usmanmehmood55/FYP-PCB/BOM FYP_PCB.xlsx

Item | Qty | Reference(s) | Value | LCSC Ref | Footprint | LibPart
1 | 1 | BT1 | 14.8V | C395852 | TerminalBlock:TerminalBlock_bornier-2_P5.08mm | Device:Battery
2 | 1 | BT2 | 11.1V | C395852 | TerminalBlock:TerminalBlock_bornier-2_P5.08mm | Device:Battery
3 | 2 | C1, C39 | 1uF | C77080 | Capacitor_SMD:C_0805_2012Metric | Device:C_Small
4 | 6 | C2, C3, C5, C6, C7, C8 | 0.1uF | C136621 | Capacitor_SMD:C_0805_2012Metric | Device:C_Small
5 | 8 | C4, C9, C11, C13, C19, C25, C31, C43 | 100nF | C136621 | Capacitor_SMD:C_0805_2012Metric | Device:C_Small
6 | 2 | C10, C12 | 100uF | C371251 | Capacitor_SMD:CP_Elec_8x10 | Device:CP_Small
7 | 9 | C14, C17, C20, C23, C26, C29, C32, C35, C42 | 4.7uF | C7188 | Capacitor_Tantalum_SMD:CP_EIA-3528-15_AVX-H | Device:CP_Small
8 | 8 | C15, C18, C21, C24, C27, C30, C33, C36 | 220nF | C11364 | Capacitor_Tantalum_SMD:CP_EIA-3216-18_Kemet-A | Device:CP_Small
9 | 4 | C16, C22, C28, C34 | 330uF | C110162 | Capacitor_SMD:CP_Elec_8x10 | Device:CP_Small
10 | 2 | C37, C38 | 4.7uF | C7188 | Capacitor_Tantalum_SMD:CP_EIA-3528-15_AVX-H | Device:C_Small
11 | 2 | C40, C44 | 10nF | C472835 | Capacitor_SMD:C_0805_2012Metric | Device:C_Small
12 | 1 | C41 | 2.2nF | C28260 | Capacitor_SMD:C_0805_2012Metric | Device:C_Small
13 | 2 | C45, C46 | 22pF | C129647 | Capacitor_SMD:C_0805_2012Metric | Device:C_Small
14 | 3 | D1, D2, D3 | LED | C192671 | LED_SMD:LED_0805_2012Metric_Pad1.15x1.40mm_HandSolder | Device:LED
15 | 5 | D4, D5, D6, D7, D8 | 5A | C24138 | Diode_SMD:D_SMC | Device:D_Schottky
16 | 4 | H1, H2, H3, H4 | MH | ~~~~~~~ | MountingHole:MountingHole_3.2mm_M3_Pad_Via | Mechanical:MountingHole
17 | 1 | J1 | UART | C160259 | Connector_JST:JST_EH_B3B-EH-A_1x03_P2.50mm_Vertical | Connector_Generic:Conn_01x03
18 | 1 | J2 | i2c_jetson | C160259 | Connector_JST:JST_EH_B3B-EH-A_1x03_P2.50mm_Vertical | Connector_Generic:Conn_01x03
19 | 1 | J3 | T-Block | C395852 | TerminalBlock:TerminalBlock_bornier-2_P5.08mm | Connector:Screw_Terminal_01x02
20 | 1 | J4 | USB_B_Mini | C105424 | Connector_USB:USB_Mini-B_Lumberg_2486_01_Horizontal | Connector:USB_B_Mini
21 | 2 | JP1, JP2 | SolderJumper_2_Bridged | ~~~~~~~ | Jumper:SolderJumper-2_P1.3mm_Bridged2Bar_RoundedPad1.0x1.5mm | Jumper:SolderJumper_2_Bridged
22 | 4 | L1, L2, L3, L4 | 15uH | C364084 | Inductor_SMD:L_Pulse_PA4320 | Device:L_Small
23 | 1 | L5 | 2.4uH | C325963 | Inductor_SMD:L_Pulse_PA4320 | Device:L_Small
24 | 2 | M1, M2 | PL37D | C265407 | Connector_JST:JST_EH_S6B-EH_1x06_P2.50mm_Horizontal | PL37D:PL37D
25 | 2 | M3, M4 | Servo | C160259 | Connector_JST:JST_EH_B3B-EH-A_1x03_P2.50mm_Vertical | Motor:Motor_Servo
26 | 2 | Q1, Q2 | BSS138 | C427380 | Package_TO_SOT_SMD:SOT-23 | Transistor_FET:BSS138
27 | 8 | R1, R4, R5, R6, R24, R26, R28, R30 | 10K | C237755 | Resistor_SMD:R_0805_2012Metric | Device:R_Small_US
28 | 2 | R2, R3 | 1M | C228604 | Resistor_SMD:R_0805_2012Metric | Device:R_Small_US
29 | 2 | R7, R9 | 0.1R | C149858 | Resistor_SMD:R_2512_6332Metric | Device:R_Small_US
30 | 2 | R8, R10 | 31K | C327034 | Resistor_SMD:R_0805_2012Metric | Device:R_Small_US
31 | 4 | R11, R12, R13, R14 | 1K | C269744 | Resistor_SMD:R_0805_2012Metric | Device:R_Small_US
32 | 4 | R15, R16, R17, R18 | 2K | C95700 | Resistor_SMD:R_0805_2012Metric | Device:R_Small_US
33 | 2 | R19, R20 | 10K | C237755 | Resistor_SMD:R_1206_3216Metric | Device:R_Small_US
34 | 3 | R21, R22, R23 | 83R | C229019 | Resistor_SMD:R_0805_2012Metric | Device:R_Small_US
35 | 2 | R25, R27 | 1.1K | C325794 | Resistor_SMD:R_0805_2012Metric | Device:R_Small_US
36 | 1 | R29 | 5.8k | C204215 | Resistor_SMD:R_0805_2012Metric | Device:R_Small_US
37 | 1 | R31 | 3.2k | C17609 | Resistor_SMD:R_0805_2012Metric | Device:R_Small_US
38 | 1 | R32 | 10k | C237755 | Resistor_SMD:R_0805_2012Metric | Device:R_Small_US
39 | 1 | R33 | 102k | C204145 | Resistor_SMD:R_0805_2012Metric | Device:R_Small_US
40 | 1 | R34 | 36.5k | C204450 | Resistor_SMD:R_0805_2012Metric | Device:R_Small_US
41 | 1 | R35 | 20k | C465476 | Resistor_SMD:R_0805_2012Metric | Device:R_Small_US
42 | 1 | R36 | 4.7K | C60816 | Resistor_SMD:R_0805_2012Metric | Device:R_Small_US
43 | 1 | SW1 | BOOT/FLASH | C319371 | Button_Switch_SMD:SW_SPST_CK_RS282G05A3 | Switch:SW_Push
44 | 1 | SW2 | RESET | C319371 | Button_Switch_SMD:SW_SPST_CK_RS282G05A3 | Switch:SW_Push
45 | 2 | SW3, SW4 | iChop | C4673 | Button_Switch_SMD:SW_DIP_SPSTx05_Slide_6.7x14.26mm_W8.61mm_P2.54mm_LowProfile | Switch:SW_DIP_x05
46 | 2 | U1, U2 | DRV8840 | C95203 | Package_SO:HTSSOP-28-1EP_4.4x9.7mm_P0.65mm_EP3.4x9.5mm_Mask2.4x6.17mm_ThermalVias | Driver_Motor:DRV8840
47 | 1 | U3 | ESP32-WROOM-32D | C473012 | RF_Module:ESP32-WROOM-32 | RF_Module:ESP32-WROOM-32D
48 | 1 | U4 | LSF0204 | C202288 | Package_SO:TSSOP-14-1EP_4.4x5mm_P0.65mm | LSF0204:LSF0204
49 | 4 | U5, U6, U7, U8 | TPS5450 | C114425 | Package_SO:HSOP-8-1EP_3.9x4.9mm_P1.27mm_EP2.41x3.1mm_ThermalVias | TPS5450:TPS5450
50 | 1 | U9 | LT8364 | ~~~~~~~ | Package_SO:MSOP-12-16-1EP_3x4mm_P0.5mm_EP1.65x2.85mm_ThermalVias | LT8364:LT8364
51 | 1 | U10 | CH340G | C14267 | Package_SO:SOIC-16_3.9x9.9mm_P1.27mm | Interface_USB:CH340G
52 | 1 | U11 | ESDA6V8AV5 | C268741 | Package_TO_SOT_SMD:SOT-553 | ESDA6V8AV5:ESDA6V8AV5
53 | 1 | Y1 | 12MHz | C387348 | Crystal:Crystal_SMD_3225-4Pin_3.2x2.5mm | Device:Crystal_GND24
