usmanmehmood55/FYP-PCB/FYP PCB.kicad_pcb

## KiCad design FYP PCB.kicad_pcb (2020-02-18)

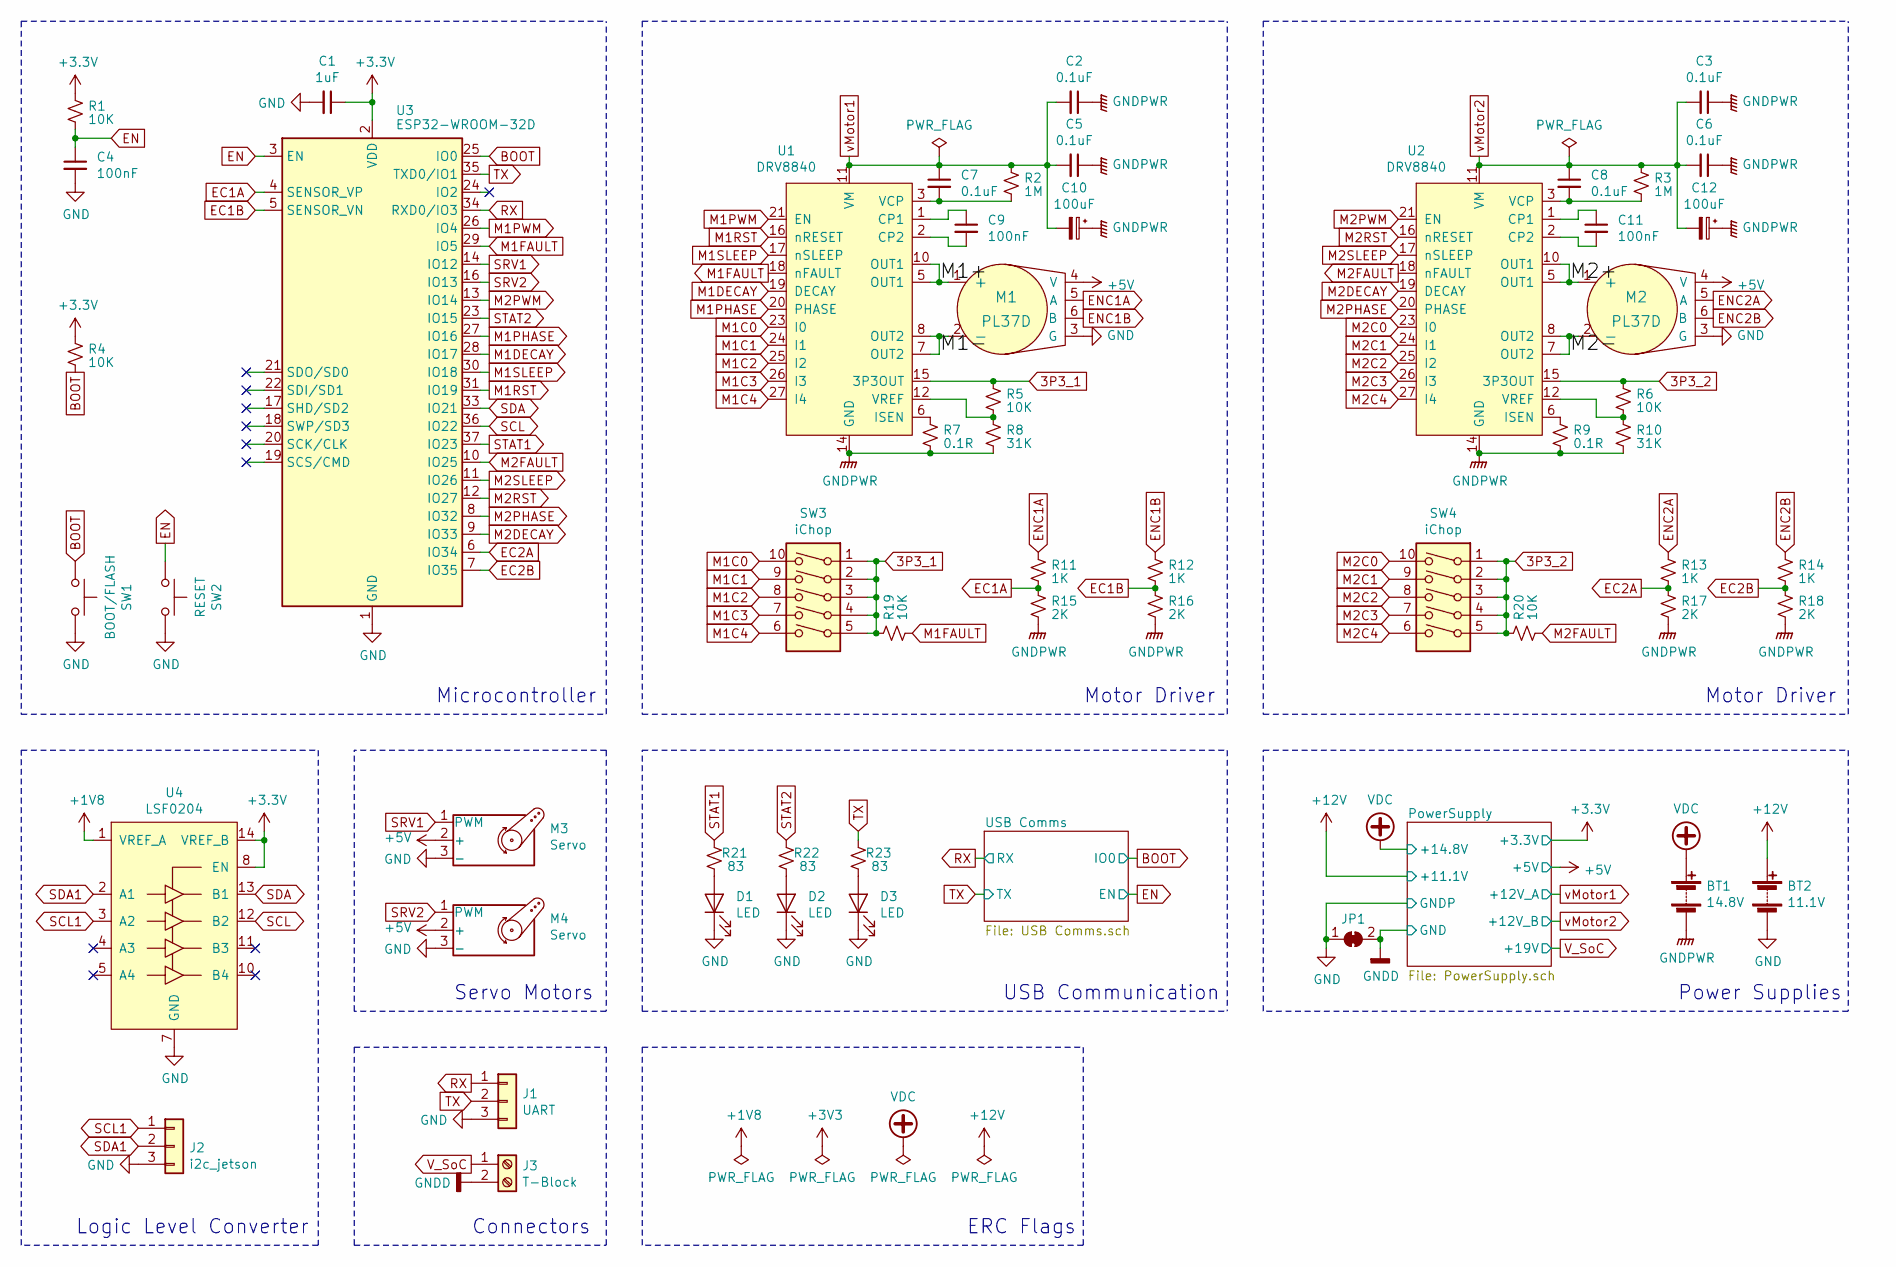
[picture p1: schematic FYP PCB.sch, Motor Driver and Power Delivery]

Parts:
BT1: 14.8V; TerminalBlock_bornier-2_P5.08mm
BT2: 11.1V; TerminalBlock_bornier-2_P5.08mm
C1: 1uF; C_0805_2012Metric
C2, C3, C5, C6, C7, C8: 0.1uF; C_0805_2012Metric
C4, C9, C11: 100nF; C_0805_2012Metric
C10, C12: 100uF; CP_Elec_8x10
D1, D2, D3: LED; LED_0805_2012Metric_Pad1.15x1.40mm_HandSolder
J1: UART; JST_EH_B3B-EH-A_1x03_P2.50mm_Vertical
J2: i2c_jetson; JST_EH_B3B-EH-A_1x03_P2.50mm_Vertical
J3: T-Block; TerminalBlock_bornier-2_P5.08mm
JP1: SolderJumper_2_Bridged; SolderJumper-2_P1.3mm_Bridged2Bar_RoundedPad1.0x1.5mm
M1, M2: PL37D; JST_EH_S6B-EH_1x06_P2.50mm_Horizontal
M3, M4: Servo; JST_EH_B3B-EH-A_1x03_P2.50mm_Vertical
R1, R4, R5, R6: 10K; R_0805_2012Metric
R2, R3: 1M; R_0805_2012Metric
R7, R9: 0.1R; R_2512_6332Metric
R8, R10: 31K; R_0805_2012Metric
R11, R12, R13, R14: 1K; R_0805_2012Metric
R15, R16, R17, R18: 2K; R_0805_2012Metric
R19, R20: 10K; R_1206_3216Metric
R21, R22, R23: 83; R_0805_2012Metric
SW1: BOOT/FLASH; SW_SPST_CK_RS282G05A3
SW2: RESET; SW_SPST_CK_RS282G05A3
SW3, SW4: iChop; SW_DIP_SPSTx05_Slide_6.7x14.26mm_W8.61mm_P2.54mm_LowProfile
U1, U2: DRV8840; HTSSOP-28-1EP_4.4x9.7mm_P0.65mm_EP3.4x9.5mm_Mask2.4x6.17mm_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
U3: ESP32-WROOM-32D; ESP32-WROOM-32
U4: LSF0204; TSSOP-14-1EP_4.4x5mm_P0.65mm

Connections:
3P3_1: R5.1, R19.1, SW3.1, SW3.2, SW3.3, SW3.4, SW3.5, U1.15 (3P3OUT)
3P3_2: R6.1, R20.1, SW4.1, SW4.2, SW4.3, SW4.4, SW4.5, U2.15 (3P3OUT)
+3V3: C1.1, R1.1, R4.1, U3.2 (VDD), U4.8 (EN), U4.14 (VREF_B); also elsewhere on the board
+5V: M1.4 (V), M2.4 (V), M3.2 (+), M4.2 (+); also elsewhere on the board
+12V: BT2.1 (+); also elsewhere on the board
/M1+: M1.1 (+), U1.5 (OUT1), U1.10 (OUT1)
/M1-: M1.2 (-), U1.7 (OUT2), U1.8 (OUT2)
/M2+: M2.1 (+), U2.5 (OUT1), U2.10 (OUT1)
/M2-: M2.2 (-), U2.7 (OUT2), U2.8 (OUT2)
BOOT: R4.2, SW1.1, U3.25 (IO0); also elsewhere on the board
EC1A: R11.2, R15.1, U3.4 (SENSOR_VP)
EC1B: R12.2, R16.1, U3.5 (SENSOR_VN)
EC2A: R13.2, R17.1, U3.6 (IO34)
EC2B: R14.2, R18.1, U3.7 (IO35)
EN: C4.1, R1.2, SW2.1, U3.3 (EN); also elsewhere on the board
ENC1A: M1.5 (A), R11.1
ENC1B: M1.6 (B), R12.1
ENC2A: M2.5 (A), R13.1
ENC2B: M2.6 (B), R14.1
GNDD: J3.2, JP1.2 (B); also elsewhere on the board
M1C0: SW3.10, U1.23 (I0)
M1C1: SW3.9, U1.24 (I1)
M1C2: SW3.8, U1.25 (I2)
M1C3: SW3.7, U1.26 (I3)
M1C4: SW3.6, U1.27 (I4)
M1DECAY: U1.19 (DECAY), U3.28 (IO17)
M1FAULT: R19.2, U1.18 (nFAULT), U3.29 (IO5)
M1PHASE: U1.20 (PHASE), U3.27 (IO16)
M1PWM: U1.21 (EN), U3.26 (IO4)
M1RST: U1.16 (nRESET), U3.31 (IO19)
M1SLEEP: U1.17 (nSLEEP), U3.30 (IO18)
M2C0: SW4.10, U2.23 (I0)
M2C1: SW4.9, U2.24 (I1)
M2C2: SW4.8, U2.25 (I2)
M2C3: SW4.7, U2.26 (I3)
M2C4: SW4.6, U2.27 (I4)
M2DECAY: U2.19 (DECAY), U3.9 (IO33)
M2FAULT: R20.2, U2.18 (nFAULT), U3.10 (IO25)
M2PHASE: U2.20 (PHASE), U3.8 (IO32)
M2PWM: U2.21 (EN), U3.13 (IO14)
M2RST: U2.16 (nRESET), U3.12 (IO27)
M2SLEEP: U2.17 (nSLEEP), U3.11 (IO26)
unnamed: C7.2, R2.2, U1.3 (VCP)
unnamed: C8.2, R3.2, U2.3 (VCP)
unnamed: C9.1, U1.1 (CP1)
unnamed: C9.2, U1.2 (CP2)
unnamed: C11.1, U2.1 (CP1)
unnamed: C11.2, U2.2 (CP2)
unnamed: D1.2 (A), R21.2
unnamed: D2.2 (A), R22.2
unnamed: D3.2 (A), R23.2
unnamed: R5.2, R8.1, U1.12 (VREF), U1.13 (VREF)
unnamed: R7.1, U1.6 (ISEN), U1.9 (ISEN)
unnamed: R9.1, U2.6 (ISEN), U2.9 (ISEN)
unnamed: R6.2, R10.1, U2.12 (VREF), U2.13 (VREF)
RX: J1.1, U3.34 (RXD0/IO3); also elsewhere on the board
SCL: U3.36 (IO22), U4.12 (B2)
SCL1: J2.1, U4.3 (A2)
SDA: U3.33 (IO21), U4.13 (B1)
SDA1: J2.2, U4.2 (A1)
SRV1: M3.1 (PWM), U3.14 (IO12)
SRV2: M4.1 (PWM), U3.16 (IO13)
STAT1: R21.1, U3.37 (IO23)
STAT2: R22.1, U3.23 (IO15)
TX: J1.2, R23.1, U3.35 (TXD0/IO1); also elsewhere on the board
VDC: BT1.1 (+); also elsewhere on the board
V_SoC: J3.1; also elsewhere on the board
vMotor1: C2.2, C5.2, C7.1, C10.2, R2.1, U1.4 (VM), U1.11 (VM); also elsewhere on the board
vMotor2: C3.2, C6.2, C8.1, C12.2, R3.1, U2.4 (VM), U2.11 (VM); also elsewhere on the board

Notes on the sheet:
Microcontroller
Logic Level Converter
ERC Flags
Power Supplies
Motor Driver
Servo Motors
Connectors
USB Communication

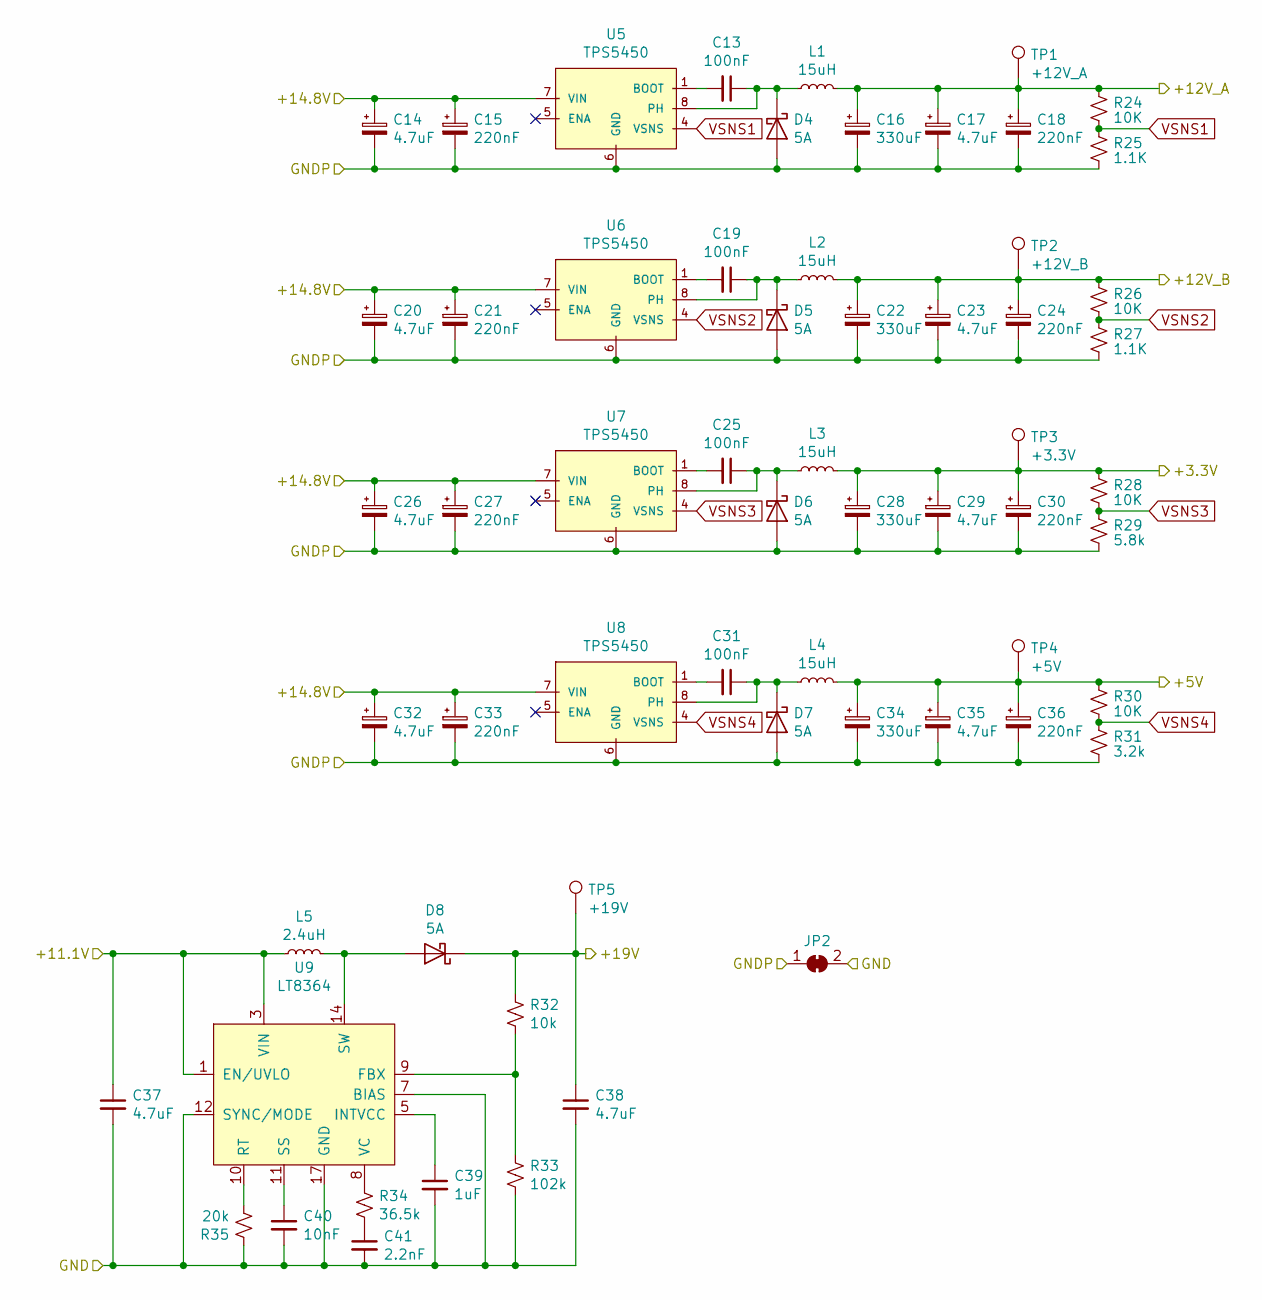
[picture p2: schematic PowerSupply.sch, Power Supplies]

Parts:
C13, C19, C25, C31: 100nF; C_0805_2012Metric
C14, C17, C20, C23, C26, C29, C32, C35, C37, C38: 4.7uF; CP_EIA-3528-15_AVX-H
C15, C18, C21, C24, C27, C30, C33, C36: 220nF; CP_EIA-3216-18_Kemet-A
C16, C22, C28, C34: 330uF; CP_Elec_8x10
C39: 1uF; C_0805_2012Metric
C40: 10nF; C_0805_2012Metric
C41: 2.2nF; C_0805_2012Metric
D4, D5, D6, D7, D8: 5A; D_SMC
JP2: SolderJumper_2_Bridged; SolderJumper-2_P1.3mm_Bridged2Bar_RoundedPad1.0x1.5mm
L1, L2, L3, L4: 15uH; L_Pulse_PA4320
L5: 2.4uH; L_Pulse_PA4320
R24, R26, R28, R30: 10K; R_0805_2012Metric
R25, R27: 1.1K; R_0805_2012Metric
R29: 5.8k; R_0805_2012Metric
R31: 3.2k; R_0805_2012Metric
R32: 10k; R_0805_2012Metric
R33: 102k; R_0805_2012Metric
R34: 36.5k; R_0805_2012Metric
R35: 20k; R_0805_2012Metric
TP1: +12V_A; TestPoint_Loop_D2.60mm_Drill0.9mm_Beaded
TP2: +12V_B; TestPoint_Loop_D2.60mm_Drill0.9mm_Beaded
TP3: +3.3V; TestPoint_Loop_D2.60mm_Drill0.9mm_Beaded
TP4: +5V; TestPoint_Loop_D2.60mm_Drill0.9mm_Beaded
TP5: +19V; TestPoint_Loop_D2.60mm_Drill0.9mm_Beaded
U5, U6, U7, U8: TPS5450; HSOP-8-1EP_3.9x4.9mm_P1.27mm_EP2.41x3.1mm_ThermalVias
U9: LT8364; MSOP-12-16-1EP_3x4mm_P0.5mm_EP1.65x2.85mm_ThermalVias

Connections:
+3V3: C28.1, C29.1, C30.1, L3.2, R28.1, TP3.1; also elsewhere on the board
+5V: C34.1, C35.1, C36.1, L4.2, R30.1, TP4.1; also elsewhere on the board
+12V: C37.1, L5.1, U9.1 (EN/UVLO), U9.3 (VIN); also elsewhere on the board
GNDD: C37.2, C38.2, C39.2, C40.2, C41.2, JP2.2 (B), R33.2, R35.1, U9.7 (BIAS), U9.12 (SYNC/MODE), U9.17 (GND); also elsewhere on the board
unnamed: C13.1, D4.1 (K), L1.1, U5.8 (PH)
unnamed: C13.2, U5.1 (BOOT)
unnamed: C19.1, D5.1 (K), L2.1, U6.8 (PH)
unnamed: C19.2, U6.1 (BOOT)
unnamed: C25.1, D6.1 (K), L3.1, U7.8 (PH)
unnamed: C25.2, U7.1 (BOOT)
unnamed: C31.1, D7.1 (K), L4.1, U8.8 (PH)
unnamed: C31.2, U8.1 (BOOT)
unnamed: C39.1, U9.5 (INTVCC)
unnamed: C40.1, U9.11 (SS)
unnamed: C41.1, R34.2
unnamed: D8.2 (A), L5.2, U9.14 (SW), U9.16 (SW)
unnamed: R32.2, R33.1, U9.9 (FBX)
unnamed: R34.1, U9.8 (VC)
unnamed: R35.2, U9.10 (RT)
VDC: C14.1, C15.1, C20.1, C21.1, C26.1, C27.1, C32.1, C33.1, U5.7 (VIN), U6.7 (VIN), U7.7 (VIN), U8.7 (VIN); also elsewhere on the board
VSNS1: R24.2, R25.1, U5.4 (VSNS)
VSNS2: R26.2, R27.1, U6.4 (VSNS)
VSNS3: R28.2, R29.1, U7.4 (VSNS)
VSNS4: R30.2, R31.1, U8.4 (VSNS)
V_SoC: C38.1, D8.1 (K), R32.1, TP5.1; also elsewhere on the board
vMotor1: C16.1, C17.1, C18.1, L1.2, R24.1, TP1.1; also elsewhere on the board
vMotor2: C22.1, C23.1, C24.1, L2.2, R26.1, TP2.1; also elsewhere on the board

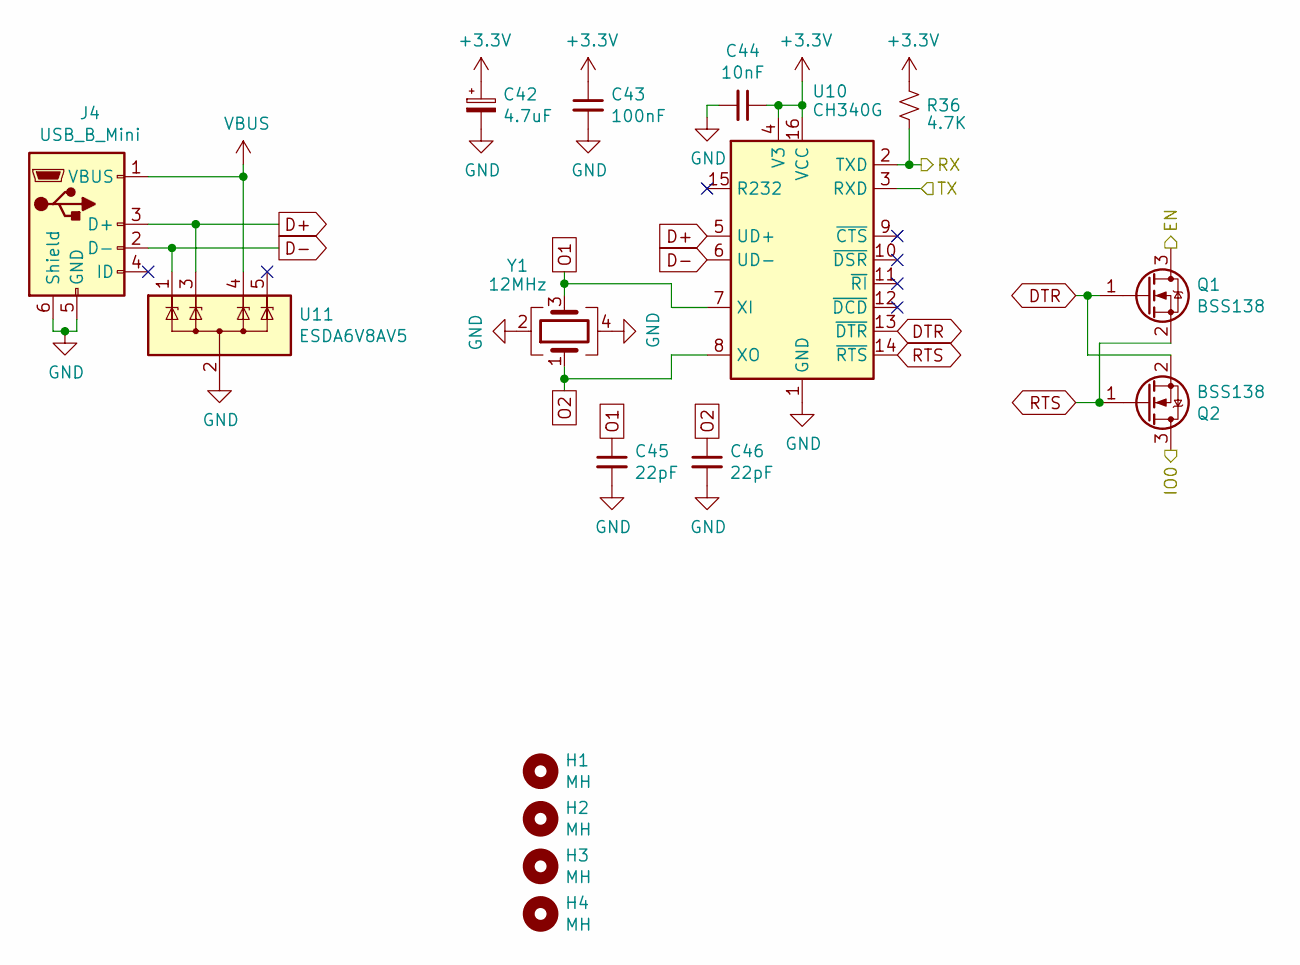
[picture p3: schematic USB Comms.sch, ESP32 DevBoard]

Parts:
C42: 4.7uF; CP_EIA-3528-15_AVX-H
C43: 100nF; C_0805_2012Metric
C44: 10nF; C_0805_2012Metric
C45, C46: 22pF; C_0805_2012Metric
H1, H2, H3, H4: MH; MountingHole_3.2mm_M3_Pad_Via
J4: USB_B_Mini; USB_Mini-B_Lumberg_2486_01_Horizontal
Q1, Q2: BSS138; SOT-23
R36: 4.7K; R_0805_2012Metric
U10: CH340G; SOIC-16_3.9x9.9mm_P1.27mm
U11: ESDA6V8AV5; SOT-553
Y1: 12MHz; Crystal_SMD_3225-4Pin_3.2x2.5mm

Connections:
+3V3: C42.1, C43.1, C44.1, R36.1, U10.4 (V3), U10.16 (VCC); also elsewhere on the board
BOOT: Q2.3 (D); also elsewhere on the board
D+: J4.3 (D+), U10.5 (UD+), U11.3
D-: J4.2 (D-), U10.6 (UD-), U11.1
DTR: Q1.1 (G), Q2.2 (S), U10.13 (~DTR)
EN: Q1.3 (D); also elsewhere on the board
O1: C45.1, U10.7 (XI), Y1.3
O2: C46.1, U10.8 (XO), Y1.1
RTS: Q1.2 (S), Q2.1 (G), U10.14 (~RTS)
RX: R36.2, U10.2 (TXD); also elsewhere on the board
TX: U10.3 (RXD); also elsewhere on the board
VBUS: J4.1 (VBUS), U11.4

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
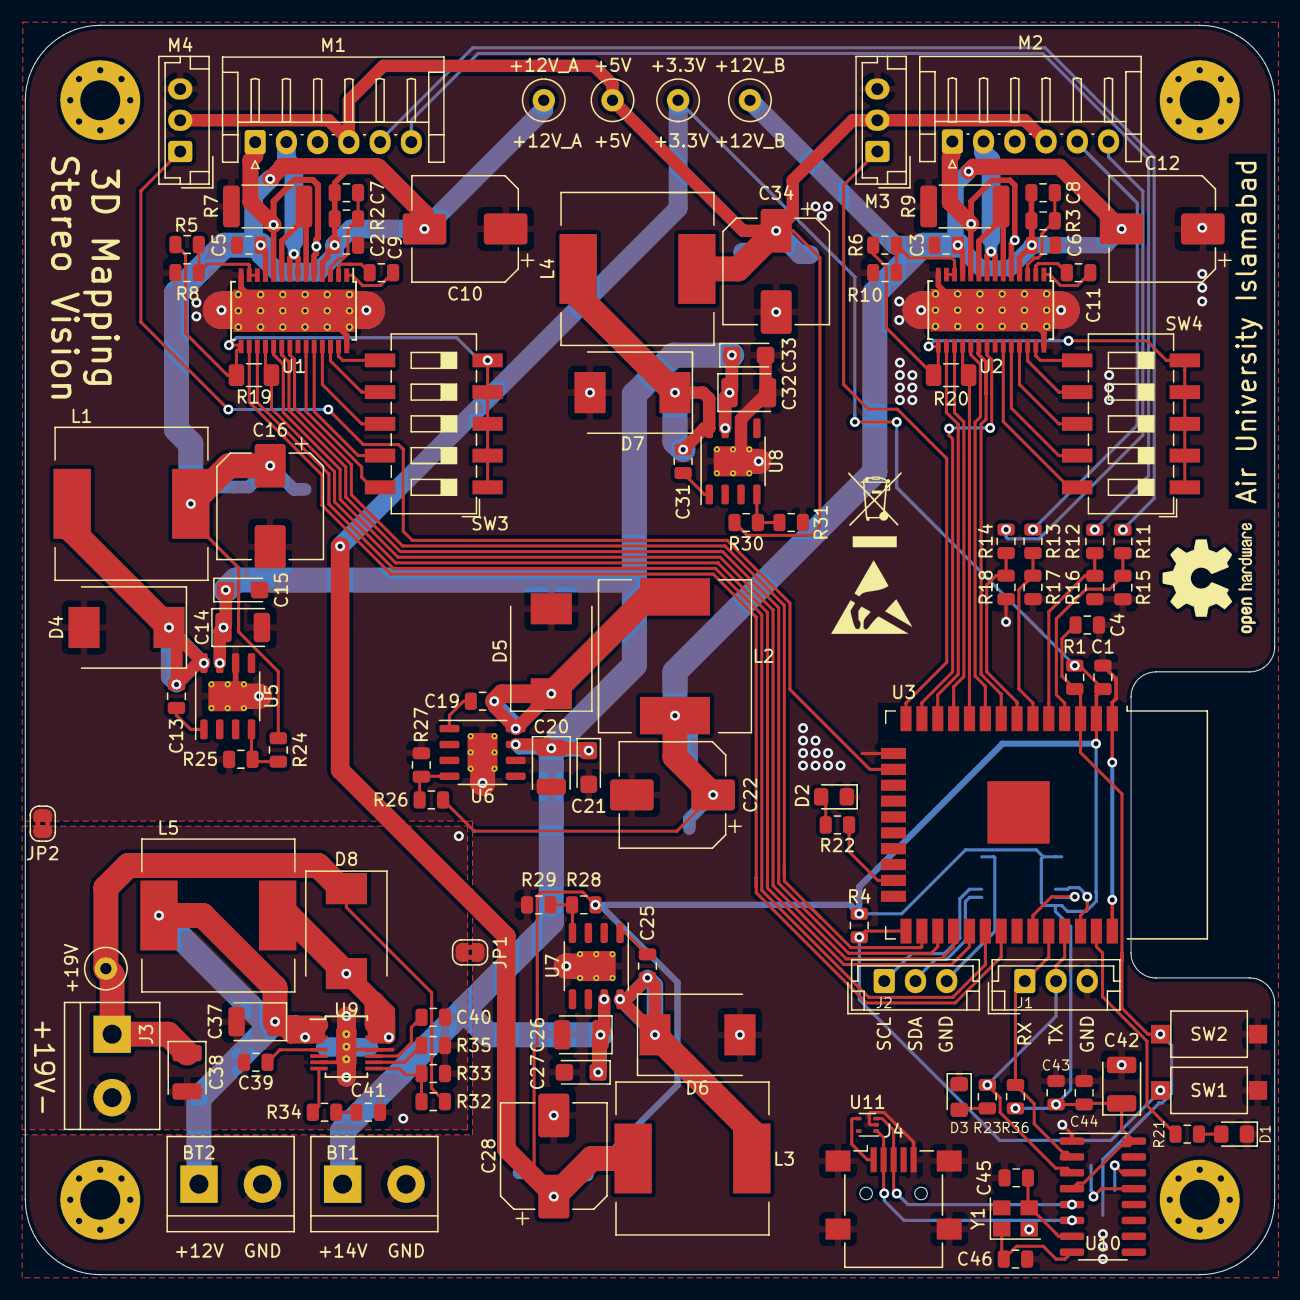
[picture p4: board FYP PCB.kicad_pcb from above]

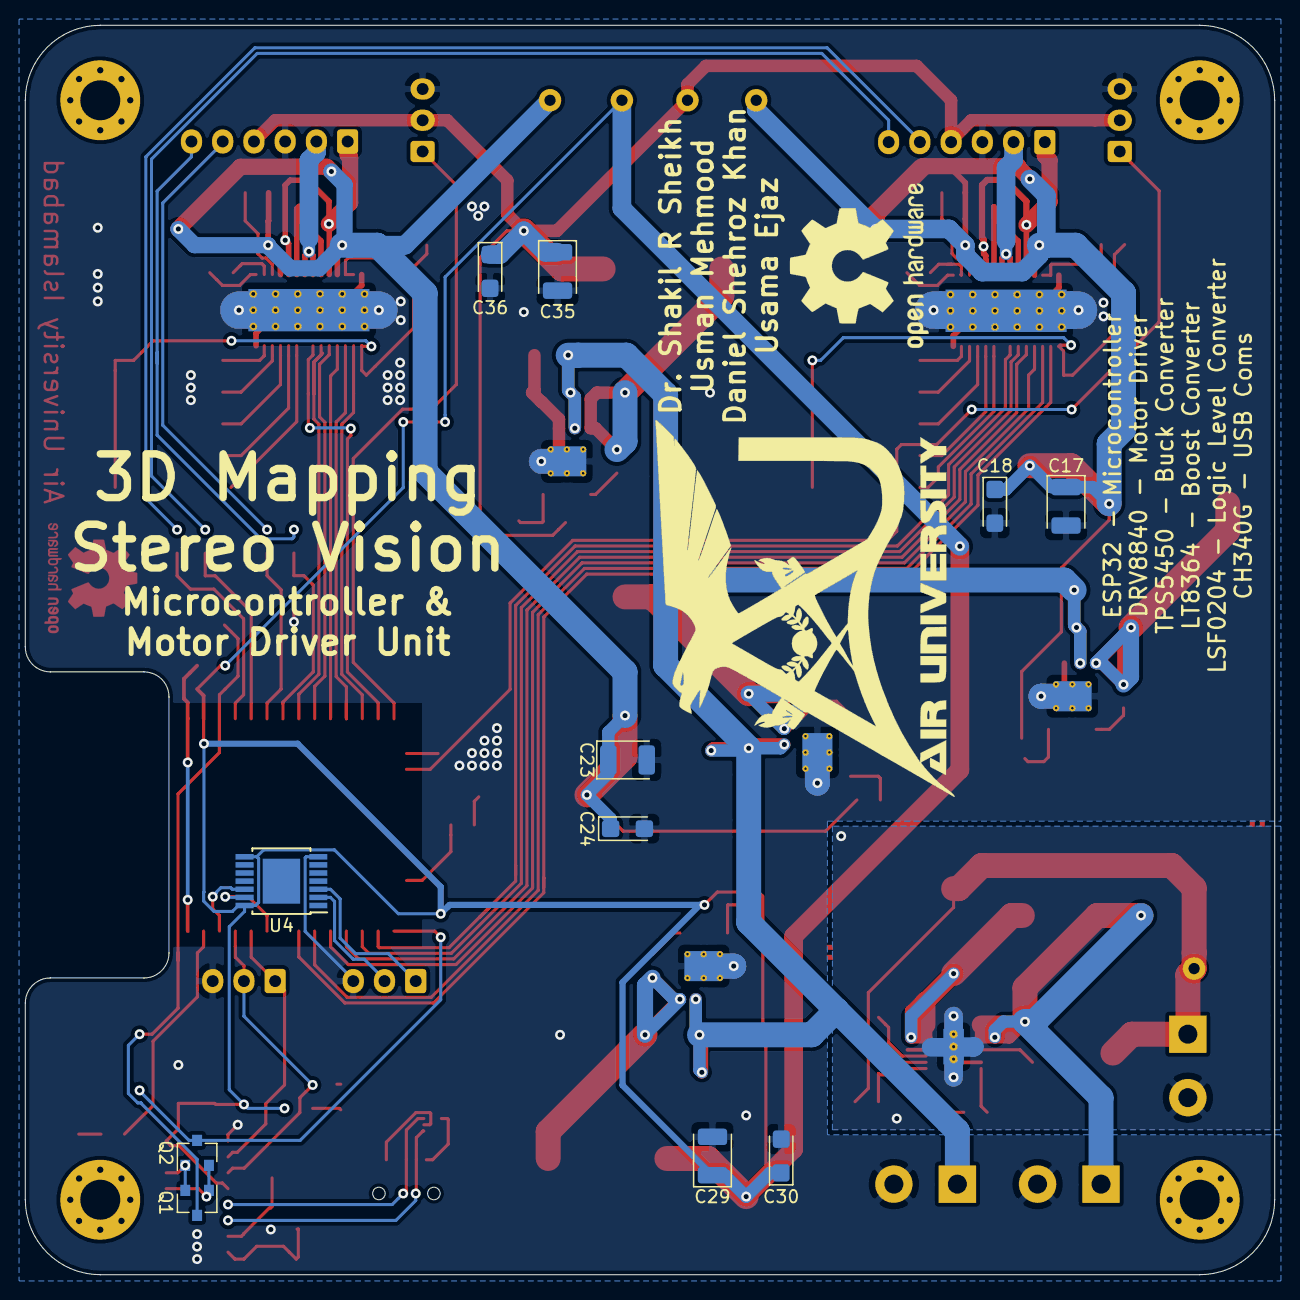
[picture p5: board FYP PCB.kicad_pcb from below]

Board: 2 copper layers, 100.0 x 100.0 mm, 138 parts (11 on the bottom side), 96 nets.

Other parts of the board:
BIN: BIN; WEEE-Logo_4.2x6mm_SilkScreen
ESD: ESD; ESD-Logo_6.6x6mm_SilkScreen
OSHW: OSHW; OSHW-Logo2_9.8x8mm_SilkScreen
OSHW#2: OSHW; OSHW-Logo2_9.8x8mm_Copper
